Jan-K-05/ESP32-Bewaesserungssteuerung/docs/images/README.md

# Bildmaterial zum Bewässerungsprojekt

Dieser Ordner enthält Screenshots des KiCad-Entwurfs und des Home-Assistant-Dashboards sowie Fotos des bislang teilweise bestückten Leiterplattenprototyps.

| Datei | Inhalt |
|---|---|
| `Bewässerung PCB.jpg` | Vorderseite des teilweise bestückten Prototyps |
| `bewässerung PCB backside.jpg` | Leiterplattenrückseite mit nachträglicher Anpassung des Regensensorsignals |
| `bewässerung PCB desgin.jpg` | Leiterplattenlayout in KiCad |
| `bewässerung PCB schaltplan.jpg` | KiCad-Schaltplan |
| `bewässerung PCB WebUI.png` | Home-Assistant-Dashboard |
