Jan-K-05/ESP32-Bewaesserungssteuerung/hardware/kicad/PCB_bewaesserung_BOM.csv

Reference | Qty | Value | Footprint
C1,C3,C5,C6 | 4 | 100nF | Capacitor_THT:C_Disc_D10.0mm_W2.5mm_P5.00mm
C2 | 1 | 470uF/25V | Capacitor_THT:CP_Radial_D8.0mm_P3.50mm
C4 | 1 | 100uF/10V | Capacitor_THT:CP_Radial_D6.3mm_P2.50mm
D1,D2,D3,D4,D5,D6,D7,D8 | 8 | 1N4007 | Diode_THT:D_DO-41_SOD81_P10.16mm_Horizontal
ESP1 | 1 | DFRobot FireBeetle 2 ESP32-E | FireBeetle_DFR0654:DFR0654
F1 | 1 | 5A | Fuse:Fuseholder_Cylinder-5x20mm_Schurter_0031_8201_Horizontal_Open
J1,J2,J3,J4,J5,J6,J7,J8,J9,J11 | 10 | Screw_Terminal_01x02 | TerminalBlock_RND:TerminalBlock_RND_205-00287_1x02_P5.08mm_Horizontal
J12,J13 | 2 | Screw_Terminal_01x03 | TerminalBlock_RND:TerminalBlock_RND_205-00288_1x03_P5.08mm_Horizontal
Q1,Q2,Q3,Q4,Q5,Q6,Q7,Q8 | 8 | IRLZ44N | Package_TO_SOT_THT:TO-220-3_Vertical
R1,R4,R7,R8,R13,R14,R15,R16,R17,R19 | 10 | 10kR | Resistor_THT:R_Axial_DIN0207_L6.3mm_D2.5mm_P10.16mm_Horizontal
R2,R3,R5,R6,R9,R10,R11,R12 | 8 | 300R | Resistor_THT:R_Axial_DIN0207_L6.3mm_D2.5mm_P10.16mm_Horizontal
R18 | 1 | 20kR | Resistor_THT:R_Axial_DIN0207_L6.3mm_D2.5mm_P10.16mm_Horizontal
R20 | 1 | 47kR | Resistor_THT:R_Axial_DIN0207_L6.3mm_D2.5mm_P10.16mm_Horizontal
U1 | 1 | TSR2-2450N | Converter_DCDC:Converter_DCDC_TRACO_TSR2-24xxN_TSR2-24xxxN_THT
