Jan-K-05/ESP32-Bewaesserungssteuerung/hardware/kicad/PCB_bewässerung.kicad_pcb

## KiCad design hardware/kicad/PCB_bewässerung.kicad_pcb (2026-11-09)

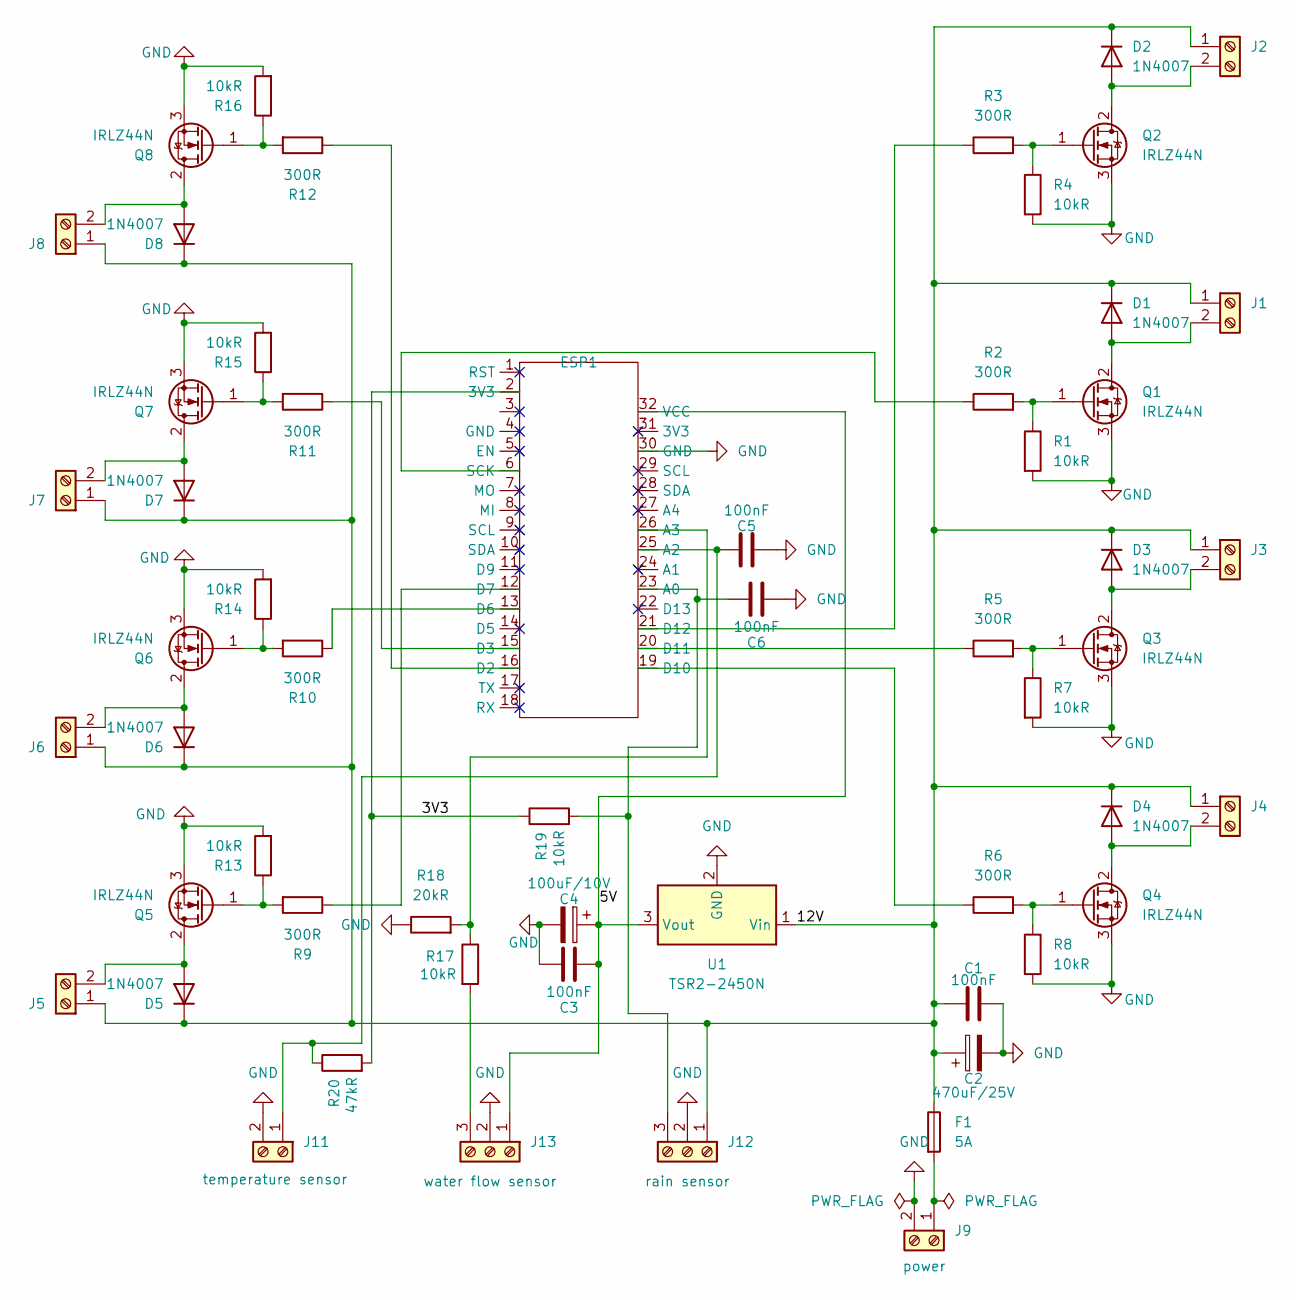
[picture p6: schematic PCB_bewässerung.kicad_sch]

Parts:
C1, C3, C5, C6: 100nF; C_Disc_D10.0mm_W2.5mm_P5.00mm
C2: 470uF/25V; CP_Radial_D8.0mm_P3.50mm
C4: 100uF/10V; CP_Radial_D6.3mm_P2.50mm
D1, D2, D3, D4, D5, D6, D7, D8: 1N4007; D_DO-41_SOD81_P10.16mm_Horizontal
ESP1: DFR0654
F1: 5A; Fuseholder_Cylinder-5x20mm_Schurter_0031_8201_Horizontal_Op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
J1, J2, J3, J4, J5, J6, J7, J8, J9, J11: Screw_Terminal_01x02; TerminalBlock_RND_205-00287_1x02_P5.08mm_Horizontal
J12, J13: Screw_Terminal_01x03; TerminalBlock_RND_205-00288_1x03_P5.08mm_Horizontal
Q1, Q2, Q3, Q4, Q5, Q6, Q7, Q8: IRLZ44N; TO-220-3_Vertical
R1, R4, R7, R8, R13, R14, R15, R16, R17, R19: 10kR; R_Axial_DIN0207_L6.3mm_D2.5mm_P10.16mm_Horizontal
R2, R3, R5, R6, R9, R10, R11, R12: 300R; R_Axial_DIN0207_L6.3mm_D2.5mm_P10.16mm_Horizontal
R18: 20kR; R_Axial_DIN0207_L6.3mm_D2.5mm_P10.16mm_Horizontal
R20: 47kR; R_Axial_DIN0207_L6.3mm_D2.5mm_P10.16mm_Horizontal
U1: TSR2-2450N; Converter_DCDC_TRACO_TSR2-24xxN_TSR2-24xxxN_THT

Connections:
/3V3: ESP1.2 (3V3), R19.1, R20.2
/5V: C3.1, C4.1, ESP1.32 (VCC), J13.1, U1.3 (Vout)
/12V: C1.1, C2.1, D1.1 (K), D2.1 (K), D3.1 (K), D4.1 (K), D5.1 (K), D6.1 (K), D7.1 (K), D8.1 (K), F1.1, J1.1, J2.1, J3.1, J4.1, J5.1, J6.1, J7.1, J8.1, J12.1, U1.1 (Vin)
GND: C1.2, C2.2, C3.2, C4.2, C5.1, C6.1, ESP1.30 (GND), J9.2, J11.2, J12.2, J13.2, Q1.3 (S), Q2.3 (S), Q3.3 (S), Q4.3 (S), Q5.3 (S), Q6.3 (S), Q7.3 (S), Q8.3 (S), R1.2, R4.2, R7.2, R8.2, R13.2, R14.2, R15.2, R16.2, R18.1, U1.2 (GND)
unnamed: D1.2 (A), J1.2, Q1.2 (D)
unnamed: D2.2 (A), J2.2, Q2.2 (D)
unnamed: D3.2 (A), J3.2, Q3.2 (D)
unnamed: D4.2 (A), J4.2, Q4.2 (D)
unnamed: D5.2 (A), J5.2, Q5.2 (D)
unnamed: D6.2 (A), J6.2, Q6.2 (D)
unnamed: D7.2 (A), J7.2, Q7.2 (D)
unnamed: D8.2 (A), J8.2, Q8.2 (D)
unnamed: C6.2, ESP1.23 (A0), J12.3, R19.2
unnamed: C5.2, ESP1.25 (A2), J11.1, R20.1
unnamed: ESP1.26 (A3), R17.1, R18.2
unnamed: ESP1.16 (D2), R12.1
unnamed: ESP1.15 (D3), R11.1
unnamed: ESP1.13 (D6), R10.1
unnamed: ESP1.12 (D7), R9.1
unnamed: ESP1.19 (D10), R6.1
unnamed: ESP1.20 (D11), R5.1
unnamed: ESP1.21 (D12), R3.1
unnamed: ESP1.6 (SCK), R2.1
unnamed: F1.2, J9.1
unnamed: J13.3, R17.2
unnamed: Q1.1 (G), R1.1, R2.2
unnamed: Q2.1 (G), R3.2, R4.1
unnamed: Q3.1 (G), R5.2, R7.1
unnamed: Q4.1 (G), R6.2, R8.1
unnamed: Q5.1 (G), R9.2, R13.1
unnamed: Q6.1 (G), R10.2, R14.1
unnamed: Q7.1 (G), R11.2, R15.1
unnamed: Q8.1 (G), R12.2, R16.1

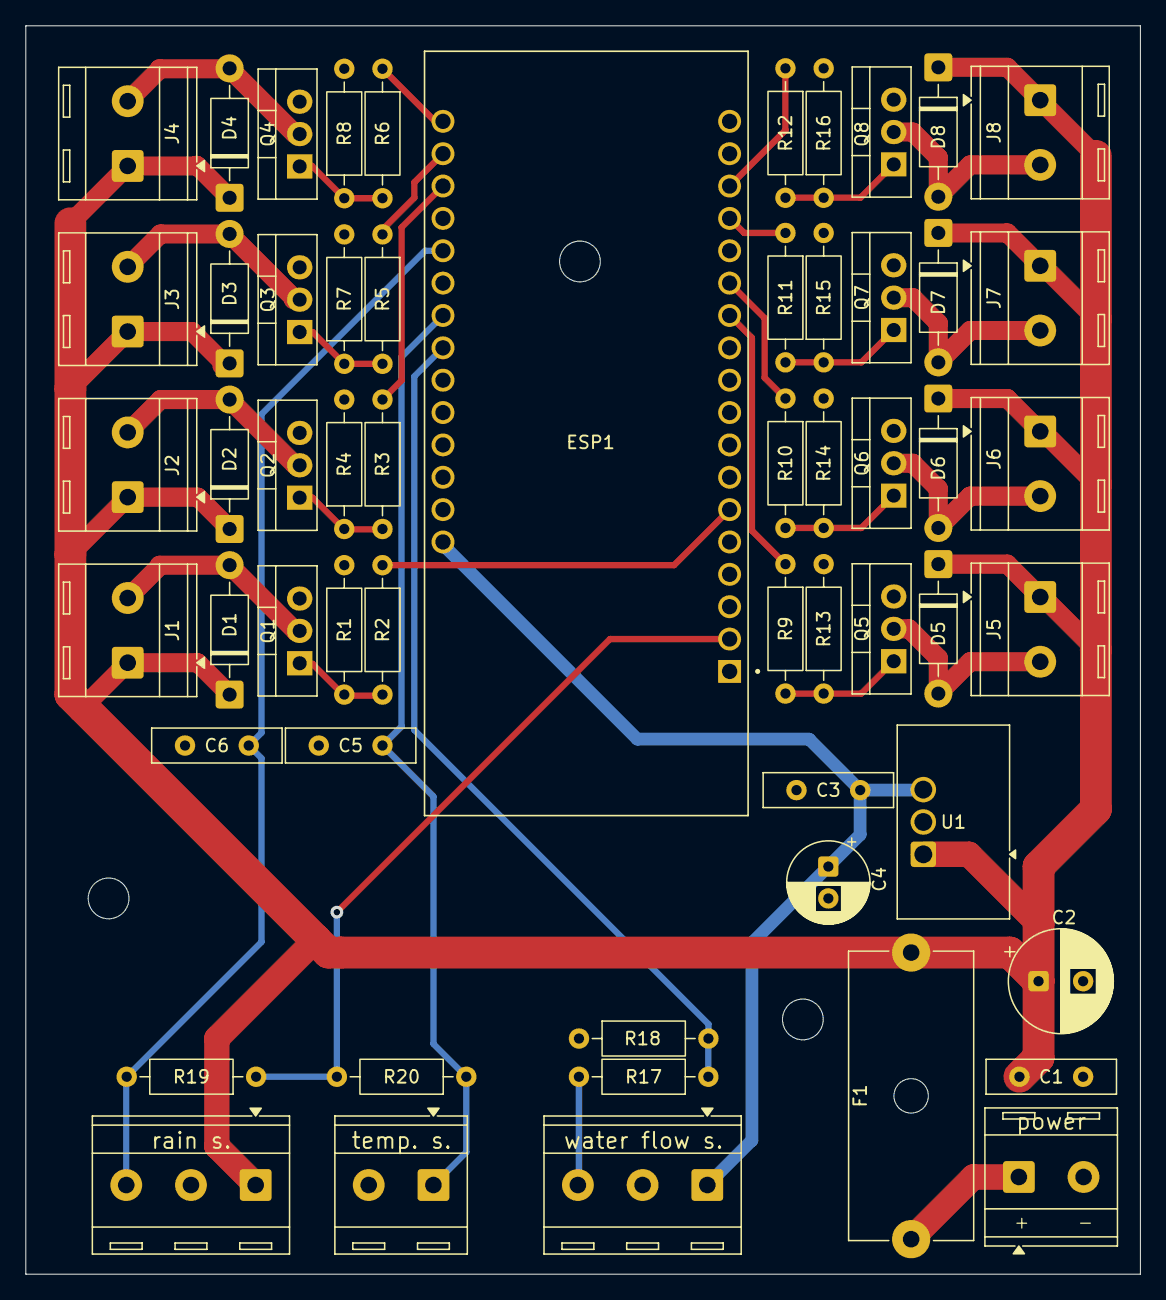
[picture p7: board PCB_bewässerung.kicad_pcb from above]

Board: 2 copper layers, 87.5 x 98.0 mm, 57 parts (0 on the bottom side), 33 nets.
